gruvin/telesoarer/reference/DAC Filter Response.png

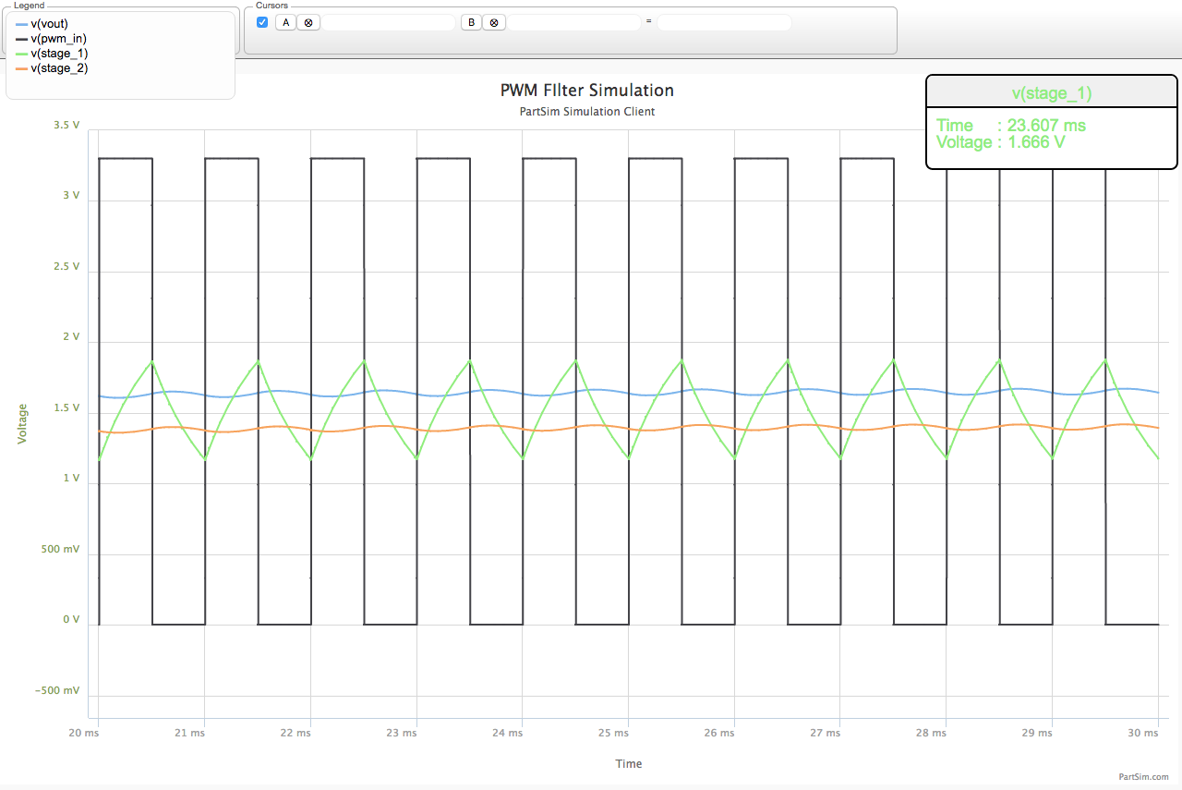
reference/DAC Filter Response.png
