gruvin/telesoarer/reference/DAC Filter Schematic.png

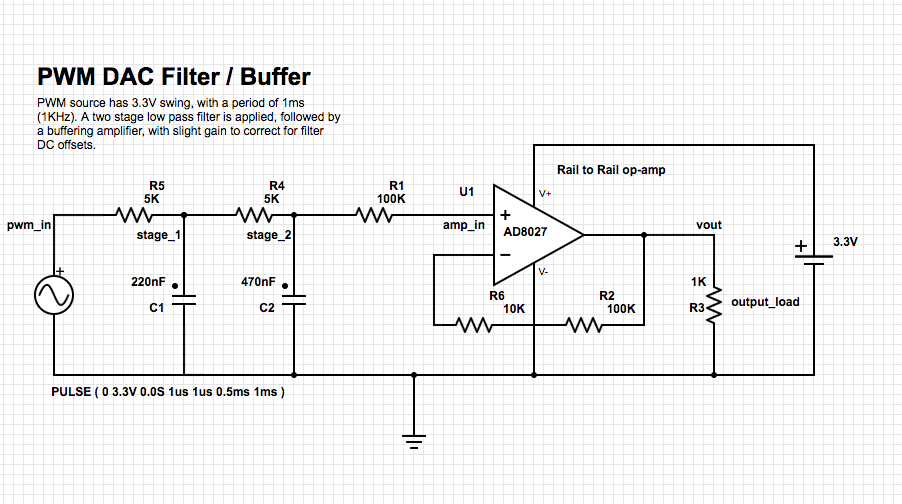
reference/DAC Filter Schematic.png
