gruvin/telesoarer/hardware/telesoarer.kicad_pcb

## KiCad design hardware/telesoarer.kicad_pcb (2016-12-20)

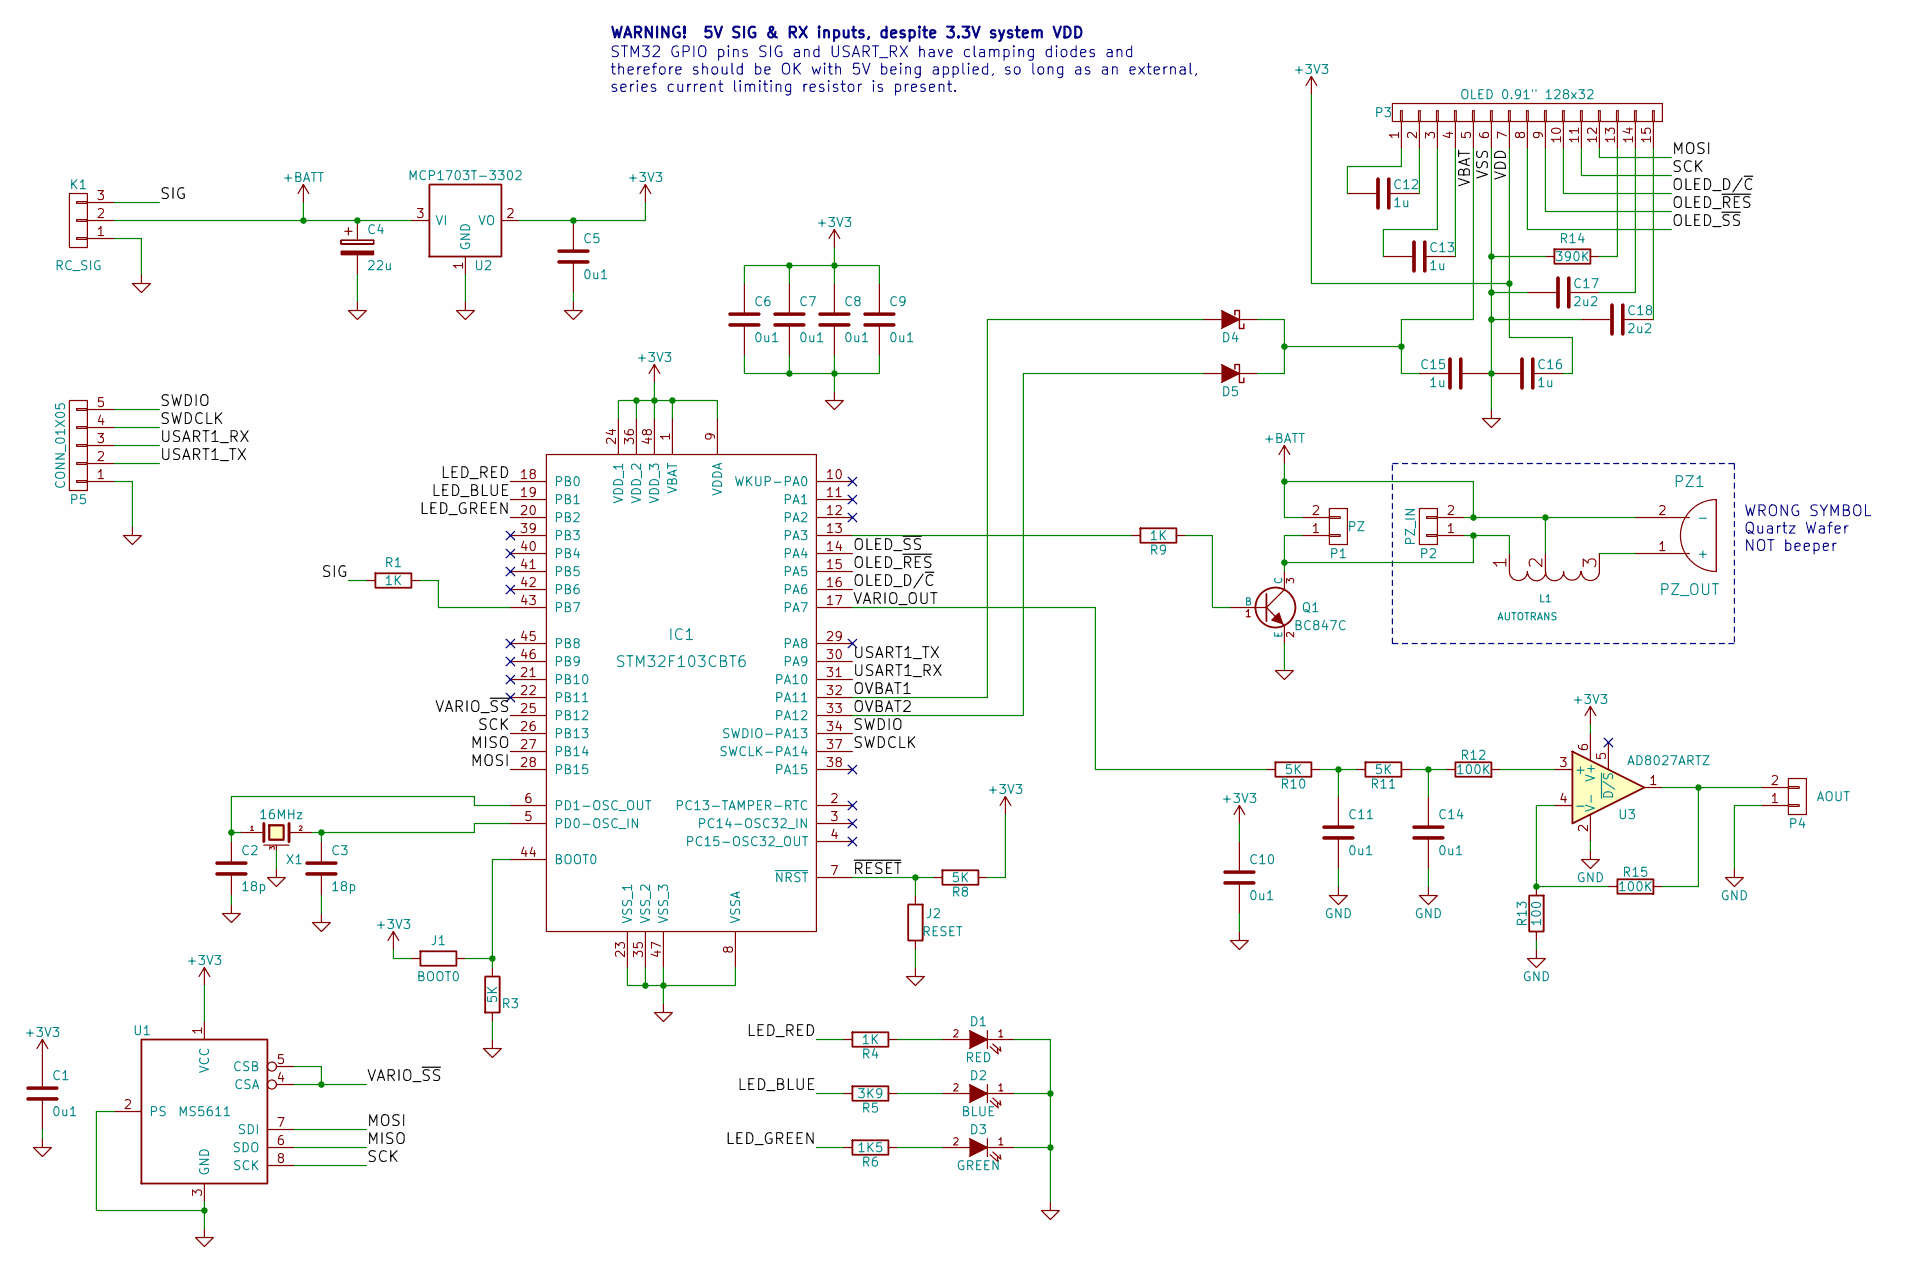
[picture p6: schematic telesoarer.sch]

Parts:
C1, C5, C6, C7, C8, C9, C10, C11, C14: 0u1; C_0402
C2, C3: 18p; C_0402
C4: 22u; TantalC_SizeS_EIA-3216
C12, C13, C15, C16: 1u; C_0402
C17, C18: 2u2; C_0402
D1: RED; LED_0603
D2: BLUE; LED_0603
D3: GREEN; LED_0603
D4, D5: D_Schottky; SOD-523
IC1: STM32F103CBT6; LQFP-48_7x7mm_Pitch0.5mm
J1: BOOT0; BR_O_0603
J2: RESET; BR_O_0603
K1: RC_SIG; Pin_Header_Angled_1x03
L1: AUTOTRANS; TRI-3
P1: PZ; JST_SH_SM02B-SRSS-TB_02x1.00mm_Angled
P2: PZ_IN; JST_SH_SM02B-SRSS-TB_02x1.00mm_Angled
P3: OLED 0.91\" 128x32; ZIF_FPC15
P4: AOUT; Pin_Header_Angled_1x02
P5: CONN_01X05; JST_SH_SM05B-SRSS-TB_05x1.00mm_Angled
PZ1: PZ_OUT; PIN_ARRAY_2X1
Q1: BC847C; SOT23-BCE
R1, R4, R9: 1K; R_0402
R3, R8, R10, R11: 5K; R_0402
R5: 3K9; R_0402
R6: 1K5; R_0402
R12, R15: 100K; R_0402
R13: 100; R_0402
R14: 390K; R_0402
U1: MS5611; MS5611_8_3mmx5mm_SMD
U2: MCP1703T-3302; SOT-23A
U3: AD8027ARTZ; SOT-23-6
X1: 16MHz; Crystal_SMD_2520_4Pads

Connections:
+3V3: C1.1, C5.1, C6.1, C7.1, C8.1, C9.1, C10.1, C16.1, IC1.1 (VBAT), IC1.9 (VDDA), IC1.24 (VDD_1), IC1.36 (VDD_2), IC1.48 (VDD_3), J1.2, P3.7, R8.1, U1.1 (VCC), U2.2 (VO), U3.6 (V+)
+BATT: C4.1, K1.2, L1.2, P1.2, P2.2, PZ1.2 (-), U2.3 (VI)
/LED_BLUE: IC1.19 (PB1), R5.2
/LED_GREEN: IC1.20 (PB2), R6.2
/LED_RED: IC1.18 (PB0), R4.2
/MISO: IC1.27 (PB14), U1.6 (SDO)
/MOSI: IC1.28 (PB15), P3.12, U1.7 (SDI)
/OLED_D/~C: IC1.16 (PA6), P3.10
/OLED_~RES: IC1.15 (PA5), P3.9
/OLED_~SS: IC1.14 (PA4), P3.8
/OVBAT1: D4.2 (A), IC1.32 (PA11)
/OVBAT2: D5.2 (A), IC1.33 (PA12)
/SCK: IC1.26 (PB13), P3.11, U1.8 (SCK)
/SIG: K1.3, R1.2
/SWDCLK: IC1.37 (SWCLK-PA14), P5.4
/SWDIO: IC1.34 (SWDIO-PA13), P5.5
/USART1_RX: IC1.31 (PA10), P5.3
/USART1_TX: IC1.30 (PA9), P5.2
/VARIO_OUT: IC1.17 (PA7), R10.2
/VARIO_~SS: IC1.25 (PB12), U1.4 (CSA), U1.5 (CSB)
/VBAT: C15.2, D4.1 (K), D5.1 (K), P3.5
/~RESET: IC1.7 (~NRST), J2.2, R8.2
GND: C1.2, C2.2, C3.2, C4.2, C5.2, C6.2, C7.2, C8.2, C9.2, C10.2, C11.2, C14.2, C15.1, C16.2, C17.2, C18.2, D1.1 (K), D2.1 (K), D3.1 (K), IC1.8 (VSSA), IC1.23 (VSS_1), IC1.35 (VSS_2), IC1.47 (VSS_3), J2.1, K1.1, P3.6, P4.1, P5.1, Q1.2 (E), R3.2, R13.1, R14.2, U1.2 (PS), U1.3 (GND), U2.1 (GND), U3.2 (V-), X1.3 (case)
unnamed: C2.1, IC1.6 (PD1-OSC_OUT), X1.1
unnamed: C3.1, IC1.5 (PD0-OSC_IN), X1.2
unnamed: C11.1, R10.1, R11.2
unnamed: C12.1, P3.2
unnamed: C12.2, P3.1
unnamed: C13.1, P3.4
unnamed: C13.2, P3.3
unnamed: C14.1, R11.1, R12.1
unnamed: C17.1, P3.14
unnamed: C18.1, P3.15
unnamed: D1.2 (A), R4.1
unnamed: D2.2 (A), R5.1
unnamed: D3.2 (A), R6.1
unnamed: IC1.13 (PA3), R9.2
unnamed: IC1.43 (PB7), R1.1
unnamed: IC1.44 (BOOT0), J1.1, R3.1
unnamed: L1.1, P1.1, P2.1, Q1.3 (C)
unnamed: L1.3, PZ1.1 (+)
unnamed: P3.13, R14.1
unnamed: P4.2, R15.2, U3.1
unnamed: Q1.1 (B), R9.1
unnamed: R12.2, U3.3 (+)
unnamed: R13.2, R15.1, U3.4 (-)

Notes on the sheet:
WRONG SYMBOL Quartz Wafer NOT beeper
STM32 GPIO pins SIG and USART_RX have clamping diodes and therefore should be OK with 5V being applied, so long as an external, series current limiting resistor is present.
WARNING! 5V SIG & RX inputs, despite 3.3V system VDD

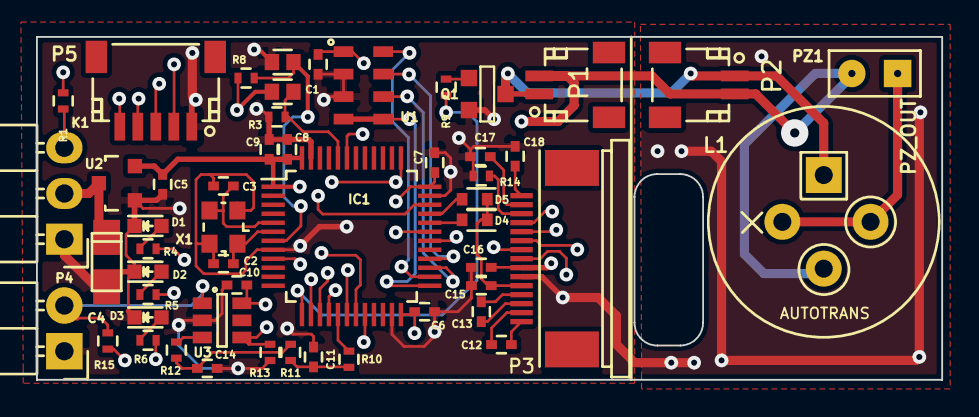
[picture p7: board telesoarer.kicad_pcb from above]

Board: 4 copper layers, 50.3 x 19.1 mm, 52 parts (0 on the bottom side), 46 nets.
