gruvin/telesoarer/firmware/telesoarer.ioc

Mcu.UserName=STM32F103CBTx
PA10.Signal=USART1_RX
PA11.GPIO_Label=OVBAT1
PA11.Signal=GPIO_Output
PA12.GPIO_Label=OVBAT2
PA12.Signal=GPIO_Output
PA13.Signal=SYS_JTMS-SWDIO
PA14.Signal=SYS_JTCK-SWCLK
PA3.GPIO_Label=PIEZO
PA3.Signal=S_TIM2_CH4
PA4.GPIO_Label=OLED_SS
PA4.Signal=GPIO_Output
PA5.GPIO_Label=OLED_RES
PA5.Signal=GPIO_Output
PA6.GPIO_Label=OLED_DC
PA6.Signal=GPIO_Output
PA7.GPIO_Label=VARIO_OUT
PA7.Signal=S_TIM3_CH2
PA9.Signal=USART1_TX
PB0.GPIO_Label=LED_RED
PB0.Signal=GPIO_Output
PB1.GPIO_Label=LED_BLUE
PB1.Signal=GPIO_Output
PB12.GPIO_Label=VARIO_SS
PB12.Signal=GPIO_Output
PB13.Signal=SPI2_SCK
PB14.Signal=SPI2_MISO
PB15.Signal=SPI2_MOSI
PB2.GPIO_Label=LED_GREEN
PB2.Signal=GPIO_Output
PB7.GPIO_Label=SIG
PB7.Signal=S_TIM4_CH2
PD0-OSC_IN.Signal=RCC_OSC_IN
PD1-OSC_OUT.Signal=RCC_OSC_OUT
