gruvin/telesoarer/(commit log)

2016-11-01 Fixed gitignore issue that was filtering out KiCAD component libraries from global_gitignore on my system. Add local git ignores for convenience of newcomers, I hope.
    [telesoarer-mlf.sch]
2016-11-01 Fixed gitignore for KiCAD component libraries (*.lib)
2016-11-01 PCB tweaks
    [telesoarer.kicad_pcb]
2016-11-02 Reduced PCB size.
    [telesoarer.kicad_pcb]
2016-11-03 Moved high voltage piezo output away from delicate analog output. Other minor changes.
    [telesoarer.kicad_pcb, telesoarer.sch]
2016-11-05 Need 16MHz xtal for Arduino bootloader serial to work -- clock too inaccurate at 8MHz RC. Added OLED display and the somewhat important 3.3V regulator I completely forgot about before!
    [telesoarer.sch]
2016-11-07 Added DAC filter from partsim.com simulation. Employs a two stage RC low pass filter, followed by an Analog Device AD8027 rail-to-rail op-amp (SOT-23 6pin 3x3mm package)
2016-11-07 Minor DAC filter scmetaic tweaks
2016-11-07 Switching to NXP ARM chip. Added reference files.
    [telesoarer.kicad_pcb, telesoarer.sch]
2016-11-11 Ripping things apart for the change to STM32 chipa
    [telesoarer.kicad_pcb, telesoarer.sch]
2016-11-23 Schematic updates for change to STM32F103 MCU
    [telesoarer.sch]
2016-11-24 STM32CubeMX Project ported into telesoarer.
2016-11-24 Added new kicad-share submodule. Uses existing KiCAD preferences path, hardware/share
2016-11-24 Completed first draft of STM32 based schematic. (Added Vario output LPF.)
    [telesoarer.sch]
2016-11-25 Work on STM32 / OLED PCB design begins
    [telesoarer.kicad_pcb, telesoarer.sch]
2016-11-25 KiCAD share update
2016-11-25 PCB progress check-in
    [telesoarer.kicad_pcb, telesoarer.sch]
2016-11-26 PCB work continues
    [_saved_telesoarer.sch, telesoarer.kicad_pcb]
2016-11-26 sub module won't sync
    [_saved_telesoarer.sch]
2016-11-26 More PCB work
    [_saved_telesoarer.sch, telesoarer.kicad_pcb, telesoarer.sch]
2016-11-26 If I don't quit now, I may find myself divorced. To the morrow, then!
    [telesoarer.kicad_pcb]
2016-11-27 MILESTONE: PCB Routing Completed (FINAL DRAFT 1)
    [telesoarer.kicad_pcb, telesoarer.sch]
2016-11-27 Oscillator Keep-out and GND shield changes
    [telesoarer.kicad_pcb]
2016-11-28 PCB updates
    [telesoarer.kicad_pcb]
2016-11-28 PCB updates -- mostly JST/FPC socket 3D packages.
    [telesoarer.kicad_pcb, telesoarer.sch]
2016-12-20 Added some PCB dimensions
    [telesoarer.kicad_pcb]
2016-12-20 STM32 flash convenience script
2016-12-22 Added breadboard prototype photo, for posterity.
