gruvin/telesoarer/(notices)

Notices in the files:
firmware/Src/main.c:
(C) COPYRIGHT STMicroelectronics *****END OF FILE
